jer-lil/3pdt-pwr-breakout-neg-V2/3pdt-pwr-breakout-neg-V2.kicad_pcb

## KiCad design 3pdt-pwr-breakout-neg-V2.kicad_pcb (2025-10-06)

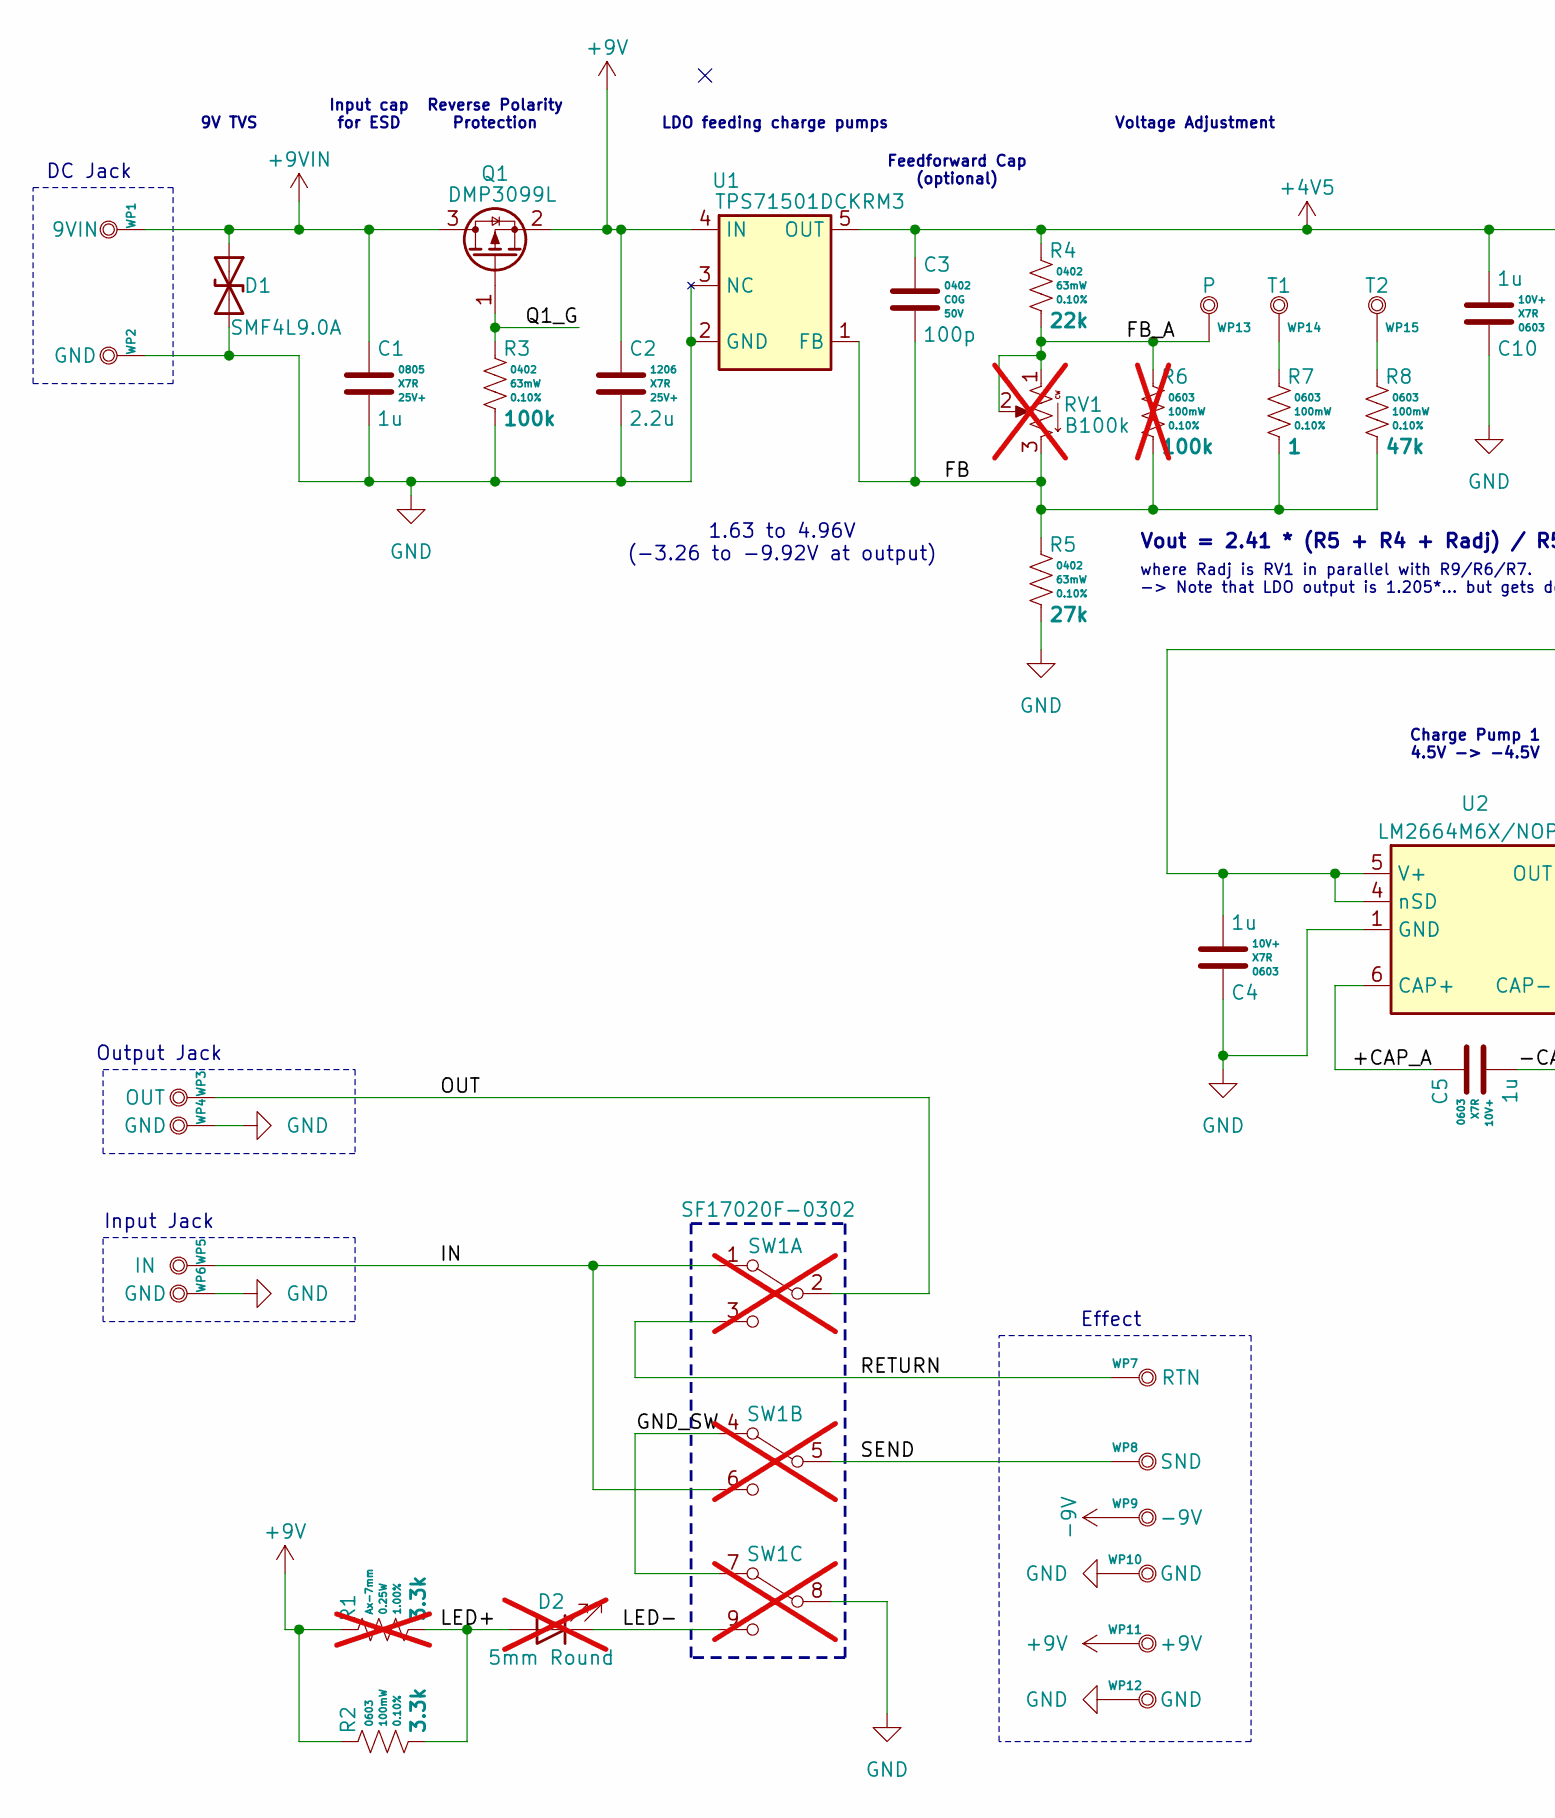
[picture p1: schematic 3pdt-pwr-breakout-neg-V2.kicad_sch, part in row 1, column 1]

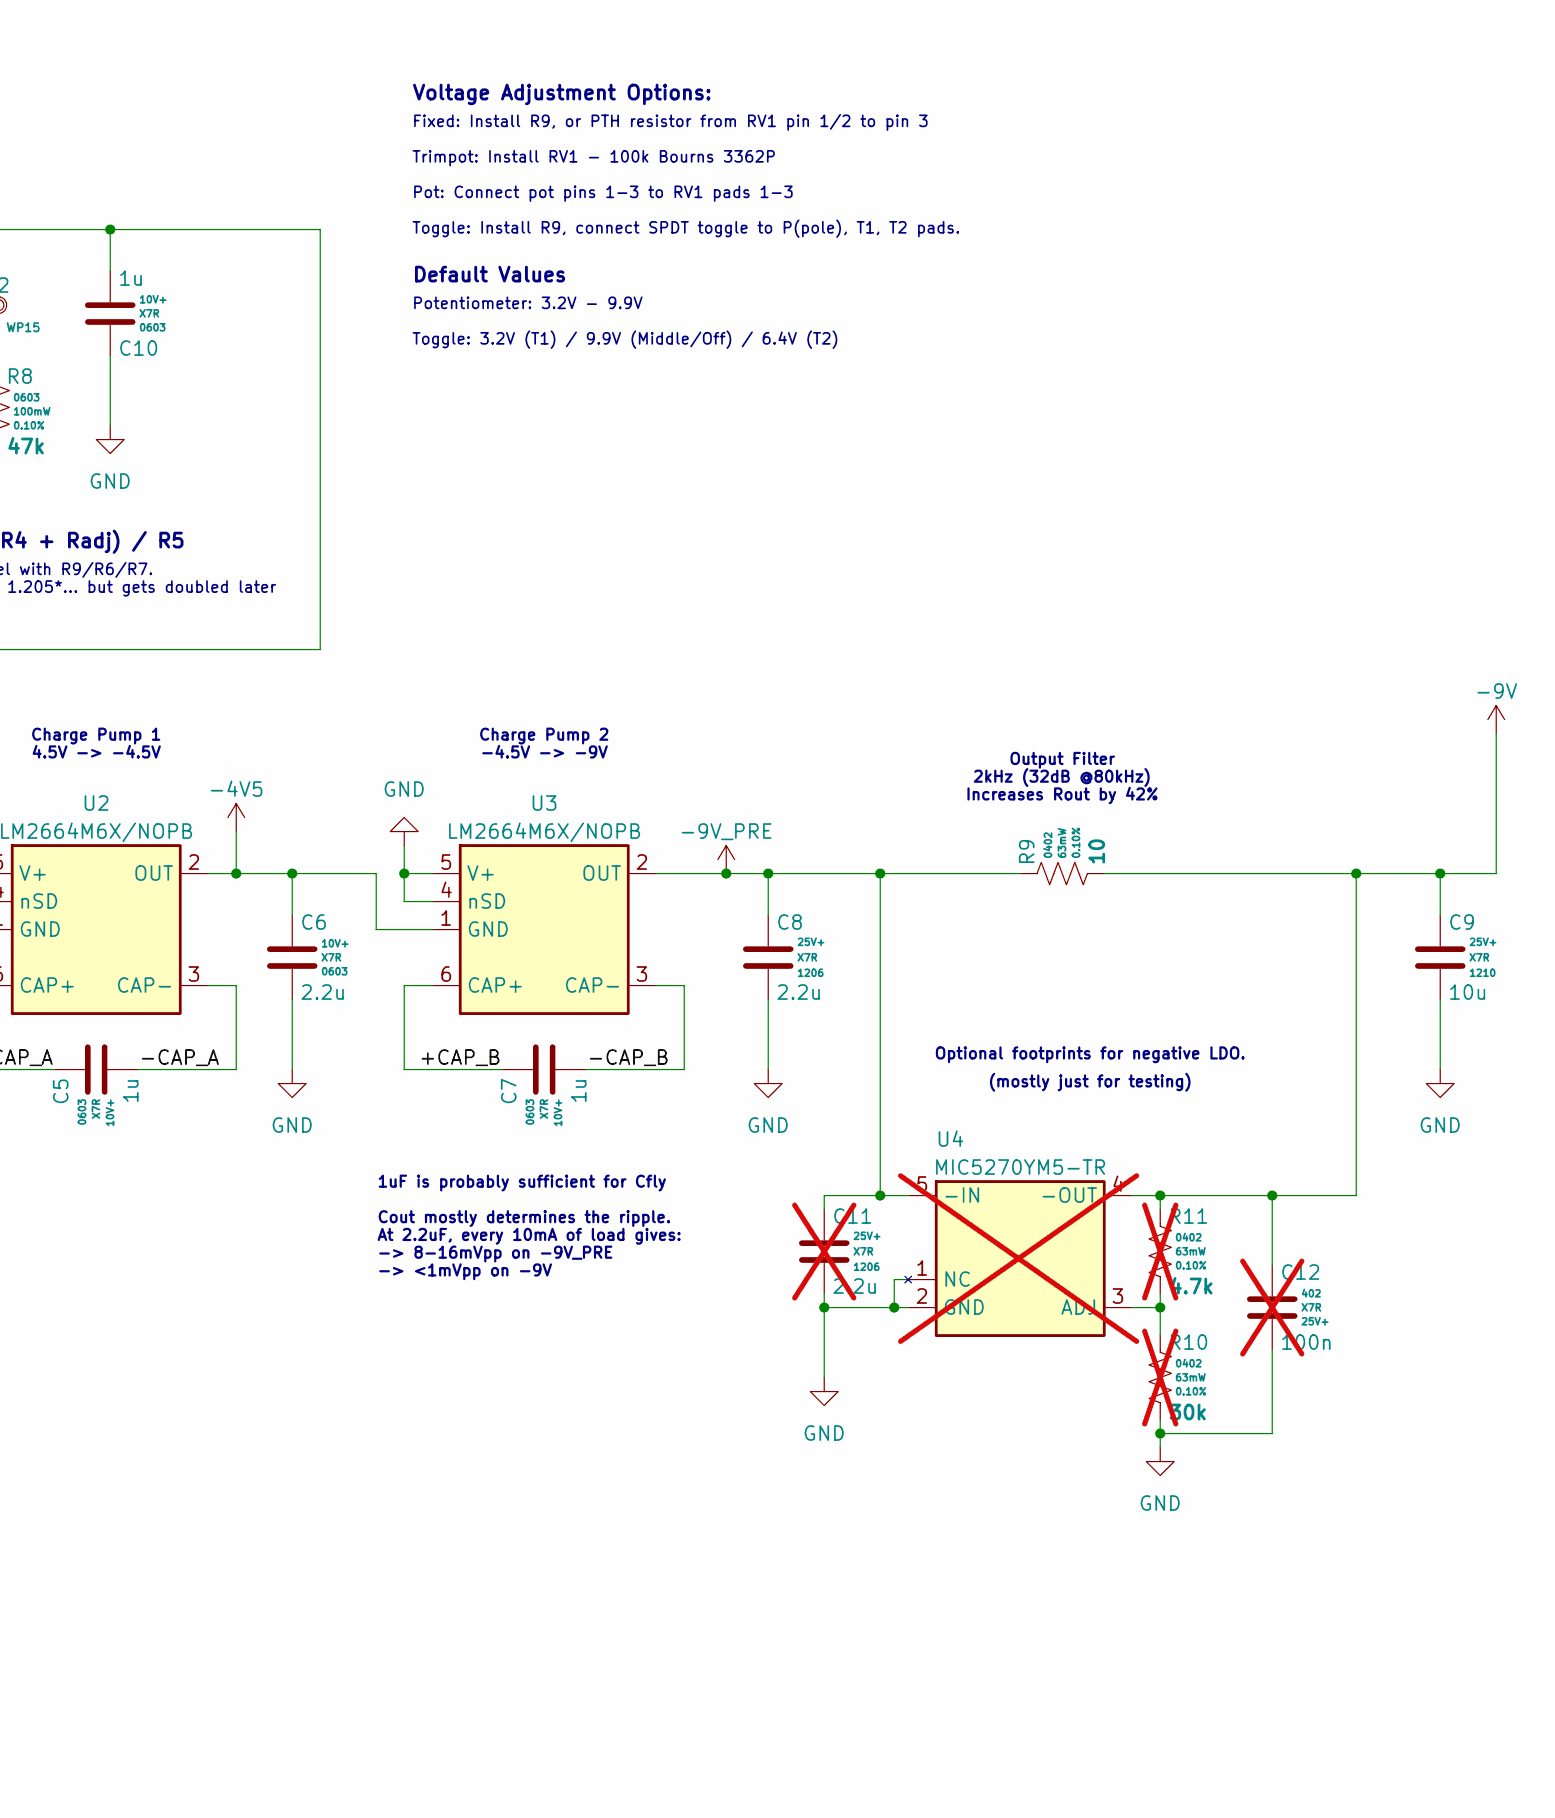
[picture p2: schematic 3pdt-pwr-breakout-neg-V2.kicad_sch, part in row 1, column 2]

Parts:
C1: 1u; C_0805_2012Metric; Voltage 25V+; Tolerance 10%; MPN C0805C105K3RACTU
C2, C8: 2.2u; C_1206_3216Metric; Voltage 25V+; Tolerance 10%; MPN C1206C225K3RACTU
C3: 100p; C_0402_1005Metric; Voltage 50V; Tolerance +/-2%; MPN GRM1555C1H100GA01D
C4, C5, C7, C10: 1u; C_0603_1608Metric; Voltage 10V+; Tolerance 10%; MPN C0603C105K8RACTU
C6: 2.2u; C_0603_1608Metric; Voltage 10V+; Tolerance 10%; MPN C0603C225K8RACTU
C9: 10u; C_1210_3225Metric; Voltage 25V+; Tolerance 10%; MPN C1210C106K3RACTU
C11: 2.2u; C_1206_3216Metric; Voltage 25V+; Tolerance 10%; MPN C1206C225K3RACTU; not fitted
C12: 100n; C_0402_1005Metric; Voltage 25V+; Tolerance 10%; MPN C0402C104K3RACTU; not fitted
D1: SMF4L9.0A; D_SOD-123F; MPN SMF4L9.0A
D2: LED_PTH; LED_D5.0mm_Standoff; not fitted
Q1: DMP3099L; SOT-23; MPN DMP3099L
R1: 3.3k; R_Axial_DIN0207_L6.3mm_D2.5mm_P7.5mm_Horizontal; Tolerance 1.00%; Voltage 250V; MPN MFR-25FBF52-3K3; not fitted
R2: 3.3k; R_0603_1608Metric; Tolerance 0.10%; Voltage 75V; MPN RT0603BRD073K3L
R3: 100k; R_0402_1005Metric; Tolerance 0.10%; Voltage 50V; MPN RT0402BRD07100KL
R4: 22k; R_0402_1005Metric; Tolerance 0.10%; Voltage 50V; MPN RT0402BRD0722KL
R5: 27k; R_0402_1005Metric; Tolerance 0.10%; Voltage 50V; MPN RT0402BRD0727KL
R6: 100k; R_0603_1608Metric; Tolerance 0.10%; Voltage 75V; MPN RT0603BRD07100KL; not fitted
R7: 1; R_0603_1608Metric; Tolerance 0.10%; Voltage 75V; MPN RT0603BRD071RL
R8: 47k; R_0603_1608Metric; Tolerance 0.10%; Voltage 75V; MPN RT0603BRD0747KL
R9: 10; R_0402_1005Metric; Tolerance 0.10%; Voltage 50V; MPN RT0402BRD0710RL
R10: 30k; R_0402_1005Metric; Tolerance 0.10%; Voltage 50V; MPN RT0402BRD0730KL; not fitted
R11: 4.7k; R_0402_1005Metric; Tolerance 0.10%; Voltage 50V; MPN RT0402BRD074K7L; not fitted
RV1: B100k; Potentiometer_Bourns_3362P_Vertical; MPN 3362P-1-104LF; not fitted
SW1: SW_3PDT; SW_STOMP_3PDT; MPN SF17020F-0302; not fitted
U1: TPS71501DCKRM3; SOT-353_SC-70-5; Voltage ADJ; MPN TPS71501DCKRM3
U2, U3: LM2664M6X/NOPB; SOT-23-6; Voltage Ratiometric; MPN LM2664M6X/NOPB
U4: MIC5270YM5-TR; SOT-23-5; Voltage ADJ; MPN MIC5270YM5-TR; not fitted
WP1: 9VIN; WirePad_H0.95mm_22-24AWG
WP2, WP4, WP6, WP10, WP12: GND; WirePad_H0.95mm_22-24AWG
WP3: OUT; WirePad_H0.95mm_22-24AWG
WP5: IN; WirePad_H0.95mm_22-24AWG
WP7: RTN; WirePad_H0.95mm_22-24AWG
WP8: SND; WirePad_H0.95mm_22-24AWG
WP9: -9V; WirePad_H0.95mm_22-24AWG
WP11: +9V; WirePad_H0.95mm_22-24AWG
WP13: P; WirePad_H0.95mm_22-24AWG
WP14: T1; WirePad_H0.95mm_22-24AWG
WP15: T2; WirePad_H0.95mm_22-24AWG

Connections:
+4V5: C3.1, C4.2, C10.2, R4.1, U1.5 (OUT), U2.4 (nSD), U2.5 (V+)
+9V: C2.1, Q1.2 (S), R1.1, R2.1, U1.4 (IN), WP11.1
+9VIN: C1.1, D1.1 (A1), Q1.3 (D), WP1.1
-4V5: C6.2, U2.2 (OUT), U3.1 (GND)
-9V: C9.1, C12.1, R9.2, R11.1, U4.4 (-OUT), WP9.1
-9V_PRE: C8.1, C11.1, R9.1, U3.2 (OUT), U4.5 (-IN)
/+CAP_A: C5.1, U2.6 (CAP+)
/+CAP_B: C7.1, U3.6 (CAP+)
/-CAP_A: C5.2, U2.3 (CAP-)
/-CAP_B: C7.2, U3.3 (CAP-)
/FB: C3.2, R5.1, R6.2, R7.2, R8.2, RV1.3, U1.1 (FB)
/FB_A: R4.2, R6.1, RV1.1, RV1.2, WP13.1
/GND_SW: SW1.4 (A), SW1.7 (A)
/IN: SW1.1 (A), SW1.6 (C), WP5.1
/LED+: D2.2 (A), R1.2, R2.2
/LED-: D2.1 (K), SW1.9 (C)
/OUT: SW1.2 (B), WP3.1
/Q1_G: Q1.1 (G), R3.1
/RETURN: SW1.3 (C), WP7.1
/SEND: SW1.5 (B), WP8.1
GND: C1.2, C2.2, C4.1, C6.1, C8.2, C9.2, C10.1, C11.2, C12.2, D1.2 (A2), R3.2, R5.2, R10.2, SW1.8 (B), U1.2 (GND), U1.3 (NC), U2.1 (GND), U3.4 (nSD), U3.5 (V+), U4.1 (NC), U4.2 (GND), WP2.1, WP4.1, WP6.1, WP10.1, WP12.1
unnamed: R7.1, WP14.1
unnamed: R8.1, WP15.1
unnamed: R10.1, R11.2, U4.3 (ADJ)

Notes on the sheet:
Default Values
Optional footprints for negative LDO.
Voltage Adjustment
where Radj is RV1 in parallel with R9/R6/R7. -> Note that LDO output is 1.205*... but gets doubled later
Reverse Polarity Protection
Effect
DC Jack
Input cap for ESD
Feedforward Cap (optional)
Voltage Adjustment Options:
Fixed: Install R9, or PTH resistor from RV1 pin 1/2 to pin 3 Trimpot: Install RV1 - 100k Bourns 3362P Pot: Connect pot pins 1-3 to RV1 pads 1-3 Toggle: Install R9, connect SPDT toggle to P(pole), T1, T2 pads.
9V TVS
1.63 to 4.96V (-3.26 to -9.92V at output)
Vout = 2.41 * (R5 + R4 + Radj) / R5
LDO feeding charge pumps
Charge Pump 1 4.5V -> -4.5V
Output Filter 2kHz (32dB @80kHz) Increases Rout by 42%
Charge Pump 2 -4.5V -> -9V
1uF is probably sufficient for Cfly Cout mostly determines the ripple. At 2.2uF, every 10mA of load gives: -> 8-16mVpp on -9V_PRE -> <1mVpp on -9V
Potentiometer: 3.2V - 9.9V Toggle: 3.2V (T1) / 9.9V (Middle/Off) / 6.4V (T2)
Output Jack
Input Jack
(mostly just for testing)

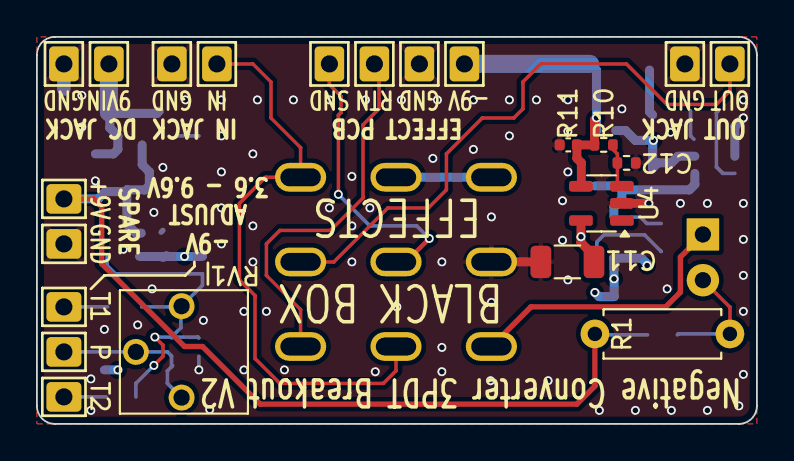
[picture p3: board 3pdt-pwr-breakout-neg-V2.kicad_pcb from above]

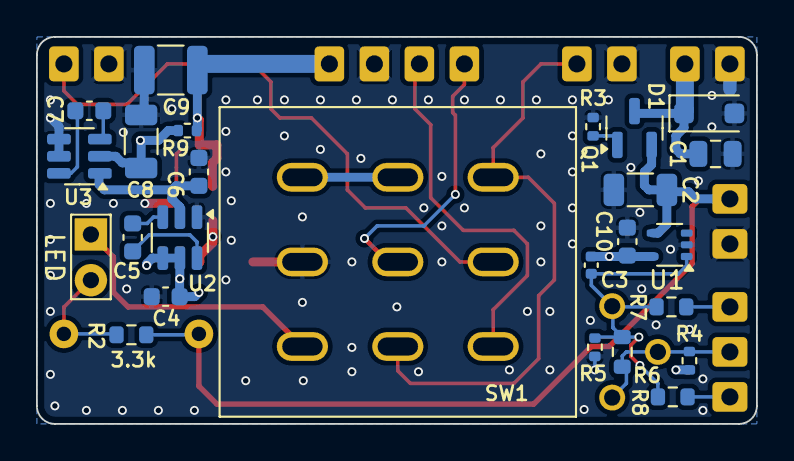
[picture p4: board 3pdt-pwr-breakout-neg-V2.kicad_pcb from below]

Board: 4 copper layers, 40.0 x 21.5 mm, 47 parts (25 on the bottom side), 24 nets.
