jer-lil/3pdt-pwr-breakout-neg-V2/(commit log)

2025-05-20 Finished layout, needs review
    no DRC yet
    [3PDT_Regulator.kicad_pcb, 3PDT_Regulator.kicad_sch, 3pdt-pwr-breakout-neg-V2.kicad_pcb, 3pdt-pwr-breakout-neg-V2.kicad_sch]
2025-05-29 Updated R amd C symbols
    Changed field sizes/visibilities. Should pull into PCB too before review
    [3pdt-pwr-breakout-neg-V2.kicad_sch]
2025-07-24 Moved wire pads, clearing warnings. Good to fab?
    [3pdt-pwr-breakout-neg-V2.kicad_pcb, 3pdt-pwr-breakout-neg-V2.kicad_sch]
2025-10-06 Changed LDO and added negative LDO
    Changed LDO to a leaded package and added an optional negative LDO. Layout changes implemented, going to review and order.
    [3pdt-pwr-breakout-neg-V2-B_Cu.gbr, 3pdt-pwr-breakout-neg-V2-B_Fab.gbr, 3pdt-pwr-breakout-neg-V2-B_Mask.gbr, 3pdt-pwr-breakout-neg-V2-B_Paste.gbr, 3pdt-pwr-breakout-neg-V2-B_Silkscreen.gbr, 3pdt-pwr-breakout-neg-V2-Edge_Cuts.gbr, 3pdt-pwr-breakout-neg-V2-F_Cu.gbr, 3pdt-pwr-breakout-neg-V2-F_Fab.gbr]
2025-10-06 Generated fab files
    [3pdt-pwr-breakout-neg-V2-B_Cu.gbr, 3pdt-pwr-breakout-neg-V2-B_Fab.gbr, 3pdt-pwr-breakout-neg-V2-B_Mask.gbr, 3pdt-pwr-breakout-neg-V2-B_Paste.gbr, 3pdt-pwr-breakout-neg-V2-B_Silkscreen.gbr, 3pdt-pwr-breakout-neg-V2-Edge_Cuts.gbr, 3pdt-pwr-breakout-neg-V2-F_Cu.gbr, 3pdt-pwr-breakout-neg-V2-F_Fab.gbr]
2025-10-06 layout stuff
    [3pdt-pwr-breakout-neg-V2-job.gbrjob]
